proconlon/room_occupancy/Documents/Prototype Presentation.pdf

# EK210 A6 H8 Prototype -Room Occupancy Monitor

### Allen Fraiman, James Conlon, Phyliss Darko, Hayden Robinson

# Problem Statement

- Design a device for administrators to monitor and control classroom occupancy,

preventing overcrowding for health, safety, and compliance with fire and disease spread

regulations.

# Key Objectives

Objectives | Metrics/Specification
Count occupants entering & exiting without interference. | - Accuracy rate >90%, less than 1% undercount or overcount. - Operational range of 0-1m. - Able to process over 50 individuals per day.
Measure occupants precisely | - Counting precision with max deviation of +-1 person.
Complete count quickly | - Time from switch press to system occupancy indication should be less than 5 sec. - Should process counts within 1 sec of passing.
Determine occupancy status | - Real time occupancy update with lag time less than 5 sec. - Unmistakable indication of occupancy value/count.
Prevents overcrowding (mechanical preventer) | - Mechanical bar deploys within 2 sec after reaching maximum occupancy.
Easy to use/portable | - System setup/takedown time under 5mins. Total weight under 5kg.
Does not obstruct entry/exit | - Door closes and opens freely (even when arm is deployed). - No reduction in entry/exit flow rate under normal operation.

## Key Means - 28BYJ-48 Stepper Motor with ULN2003 Driver

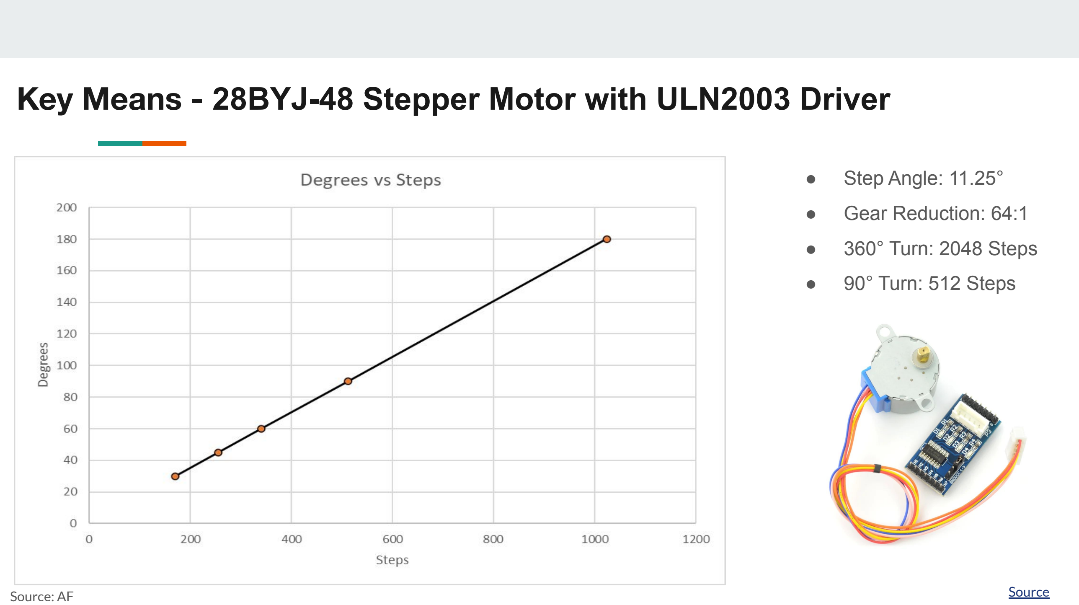
[picture p21: page 4]

Source: AF

- Step Angle: 11.25°
- Gear Reduction: 64:1
- 360° Turn: 2048 Steps
- 90° Turn: 512 Steps

Source (https://botland.store/stepper-motors/12807-stepper-motor-28byj-48-5v-01a-003nm-with-uln2003-controller-5904422306410.html)

# Key Means - Ultrasonic sensor - HC-SR04

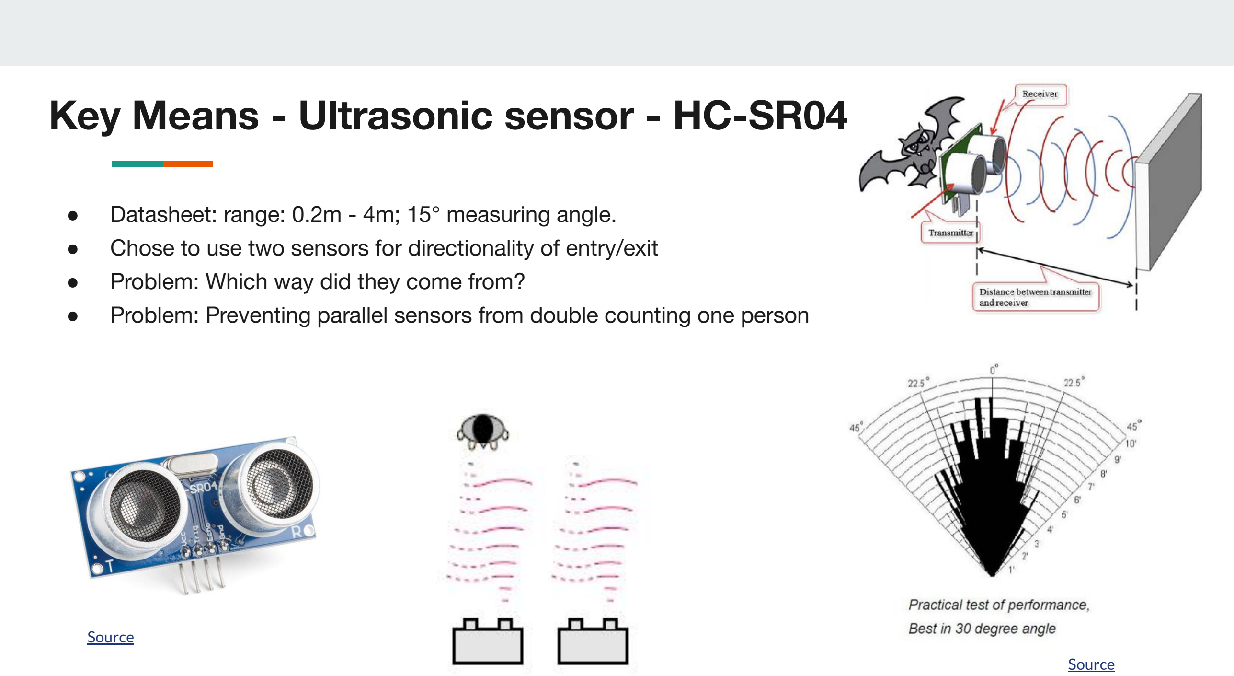
[picture p22: page 5]

- Datasheet: range: 0.2m - 4m; 15° measuring angle.
- Chose to use two sensors for directionality of entry/exit
- Problem: Which way did they come from?
- Problem: Preventing parallel sensors from double counting one person

Source (https://www.google.com/url?psig=AOvVaw3A0ZzZdn3rtIKnvUuL_O-I&cd=vfe&opi=89978449)

Source (https://www.handsontec.com/dataspecs/HC-SR04-Ultrasonic.pdf)

# Ultrasonic Sensor - Design Iteration

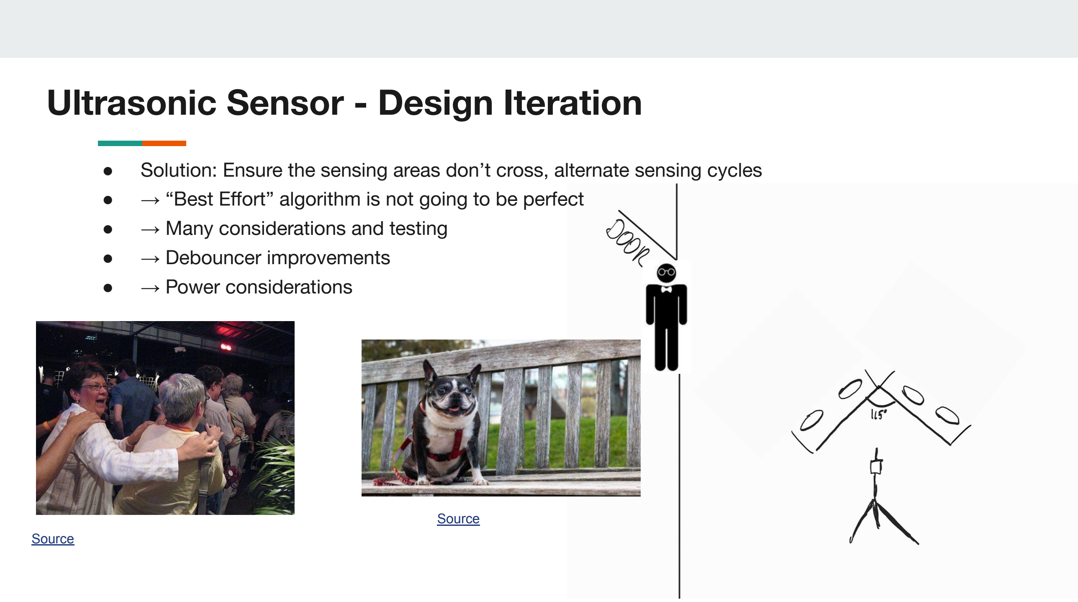
[picture p23: page 6]

- Solution: Ensure the sensing areas don’t cross, alternate sensing cycles
- → “Best Effort” algorithm is not going to be perfect
- → Many considerations and testing
- → Debouncer improvements
- → Power considerations

Source (https://en.wiktionary.org/wiki/conga_line#/media/File:Conga_Line_(2681876475).jpg)

Source (https://whdh.com/news/bu-mourning-death-of-unofficial-mascot-rhett-whose-smile-brought-joy-to-many/)

# User Group Considerations

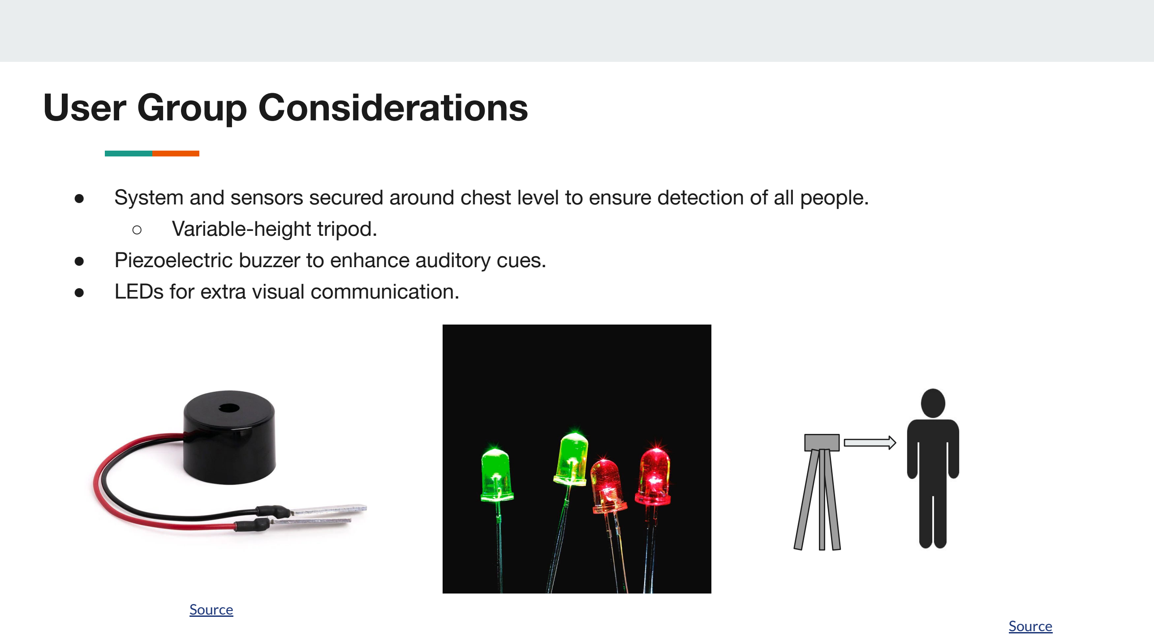
[picture p24: page 7]

- System and sensors secured around chest level to ensure detection of all people.
- Variable-height tripod.
- Piezoelectric buzzer to enhance auditory cues.
- LEDs for extra visual communication.

Source (https://www.google.com/url?psig=AOvVaw1F1aAOVAyt4_1ruHz1-brl&cd=vfe&opi=89978449)

Source (https://squishycircuits.com/products/piezoelectric-buzzer)

# Housing

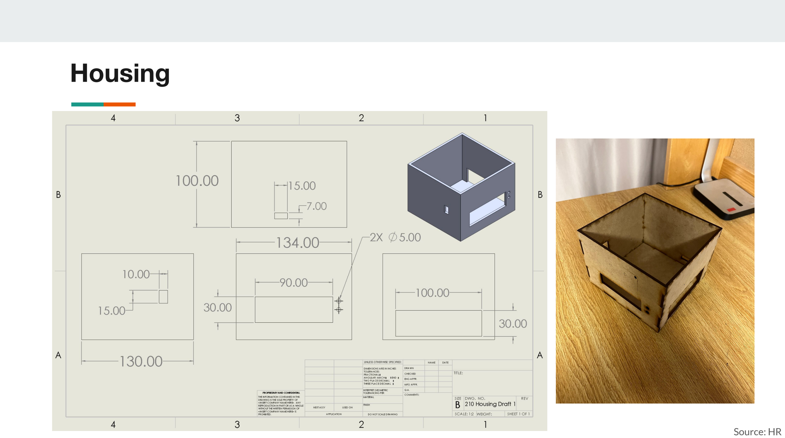
[picture p25: page 8]

Source: HR

# Mounting Components

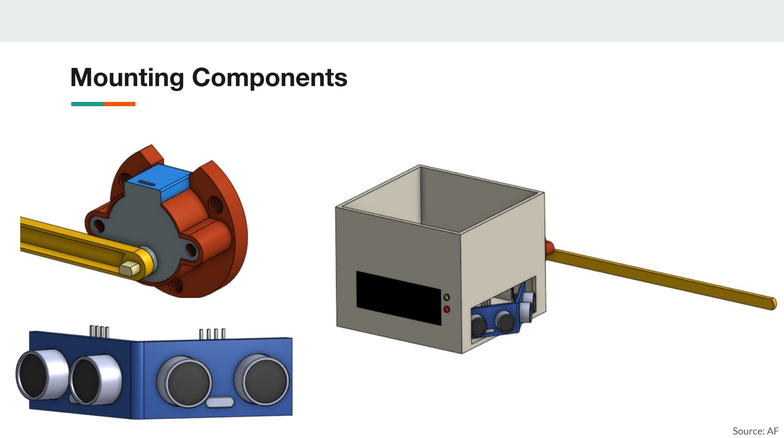
[picture p26: page 9]

Source: AF

# Circuit Diagram

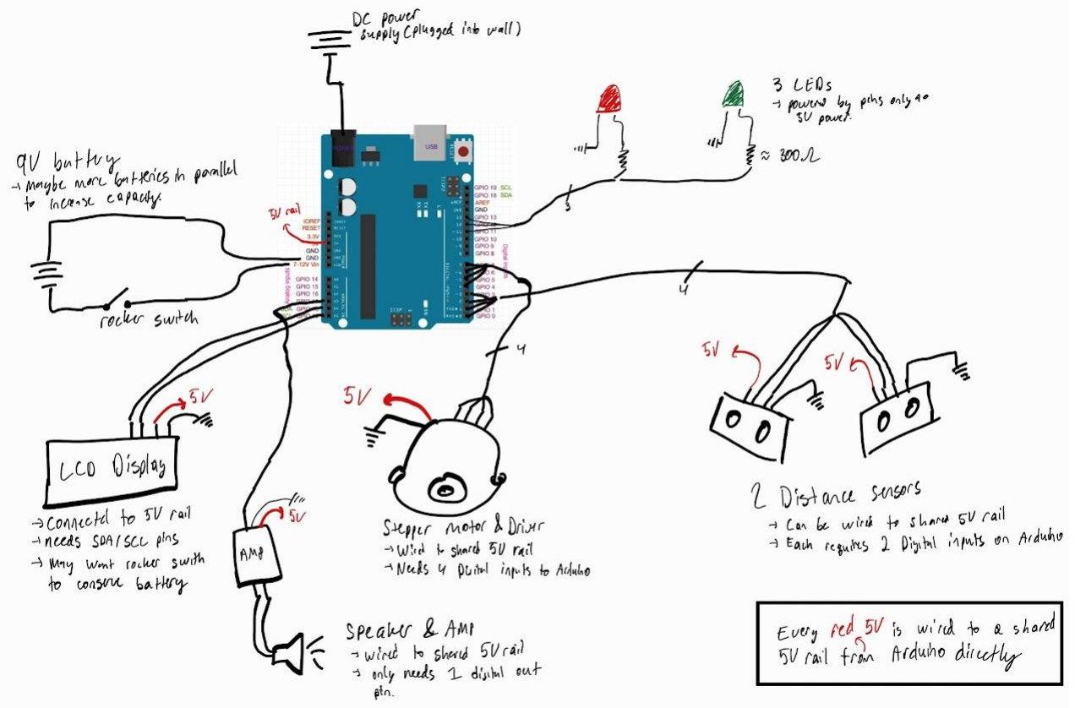
[picture p27: figure]

Source: JC

# Prototype Video

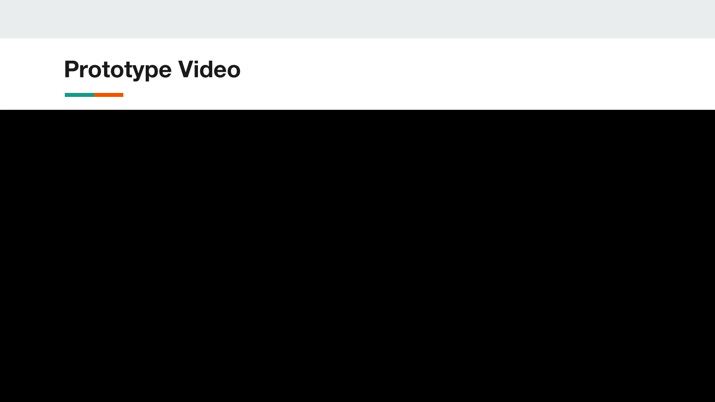
[picture p28: page 11]

# Initial Sensor/Code Testing

Max Occupant Value | # of People Walking Through | Count (In) | Did Bar Deploy? | Green LED Off? | Red LED On?
3 | 3 | 3 | Yes | Yes | Yes
4 | 5 | 5 | Yes | Yes | Yes
5 | 6 | 5 | Yes | Yes | Yes
6 | 6 | 5 | No | No | No
7 | 8 | 8 | Yes | Yes | Yes
8 | 8 | 8 | Yes | Yes | Yes

# Different Speed Testing

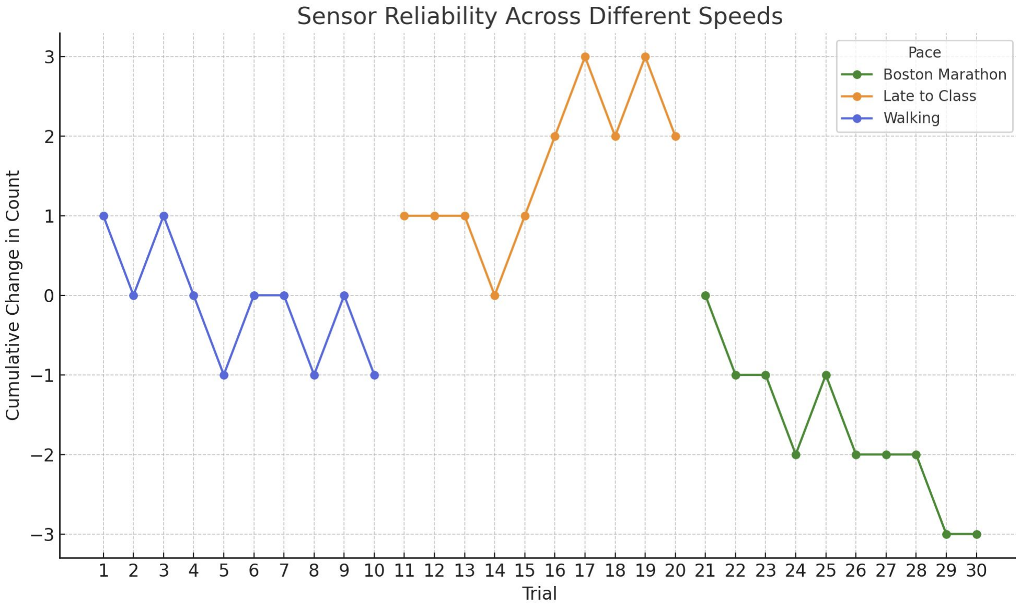
[picture p29: figure]

- We did 10 trials for each speed alternating in/out.
- So the final result should be close to zero for all 3 speeds
- notice that the blue (walking) is the closest to 0
- straight line is “missed detection” ie no change

# Looking Ahead

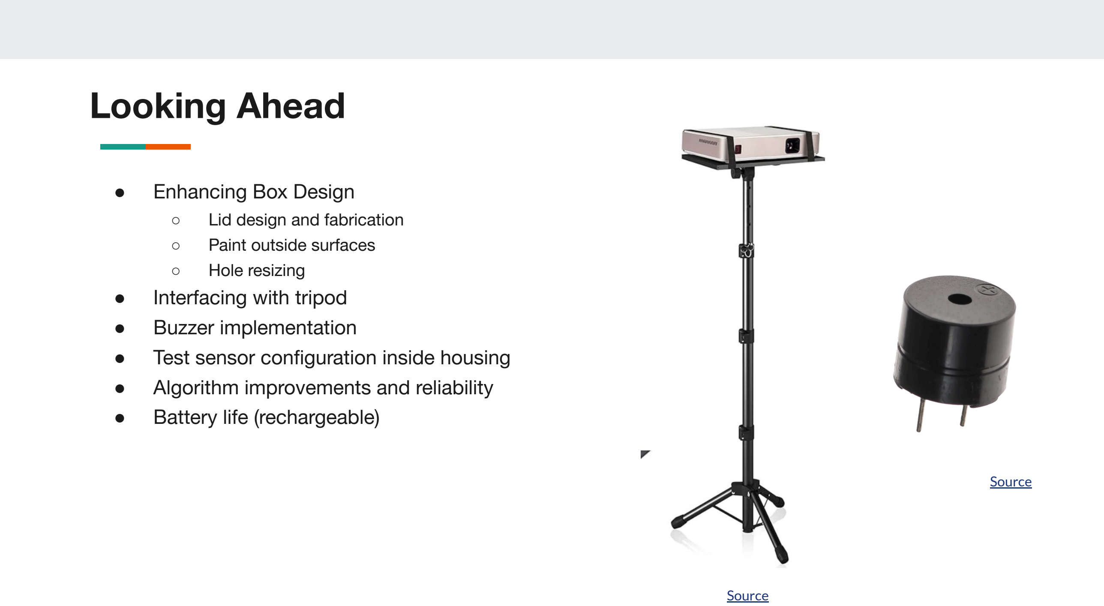
[picture p30: page 14]

- Enhancing Box Design
- Lid design and fabrication
- Paint outside surfaces
- Hole resizing
- Interfacing with tripod
- Buzzer implementation
- Test sensor configuration inside housing
- Algorithm improvements and reliability
- Battery life (rechargeable)

Source (https://www.amazon.com/Projector-Adjustable-Gooseneck-Computer-Outdoor/dp/B0BHS3SN5P/)

Source (https://www.google.com/url?psig=AOvVaw3tWCI-GKWAYNktUxHzuzR5&cd=vfe&opi=89978449)
