proconlon/room_occupancy/(commit log)

2024-03-25 added motor and lcd
2024-03-26 Working prototype
2024-04-01 fixed lcd update/clearing issue
    [distance_sensor.ino]
2024-04-01 turn off motor when not moving
2024-04-01 made sure that the arm can't move back twice
2024-04-12 buzzer and code cleanup
    [distance_sensor.ino]
2024-04-12 Modified sense algorithm - both sensors sense at the same time - after one beam is broken, the other beam senses continuously for a short period to confirm direction
    [distance_sensor.ino]
2024-04-17 improvement to LCD and sensor
2024-04-27 Improved sense algo - Added comments and removed redundant vars, functions - Fixed sense algorithm with a proper working debouncer
    [distance_sensor.ino]
2024-04-29 Modified distance sensor - Added 25000 ms timeout on the duration to stop the sensor from waiting for infinitely large distances - Changed step on stepper motor - Added delay to arm movement to sync 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
2024-04-30 Fixed buzzer and changed sensor - Distance calculation now sets to 999999 when out of bounds - Changed buzzer to tone
    [distance_sensor.ino]
2024-05-01 Final - Added presentations and reports - updated readme - small fix to code - Added python script for plots used in report
    [distance_sensor.ino]
